ugrodrigo/Controlador_MIDI_Arduino/ControladorMontado.jpg

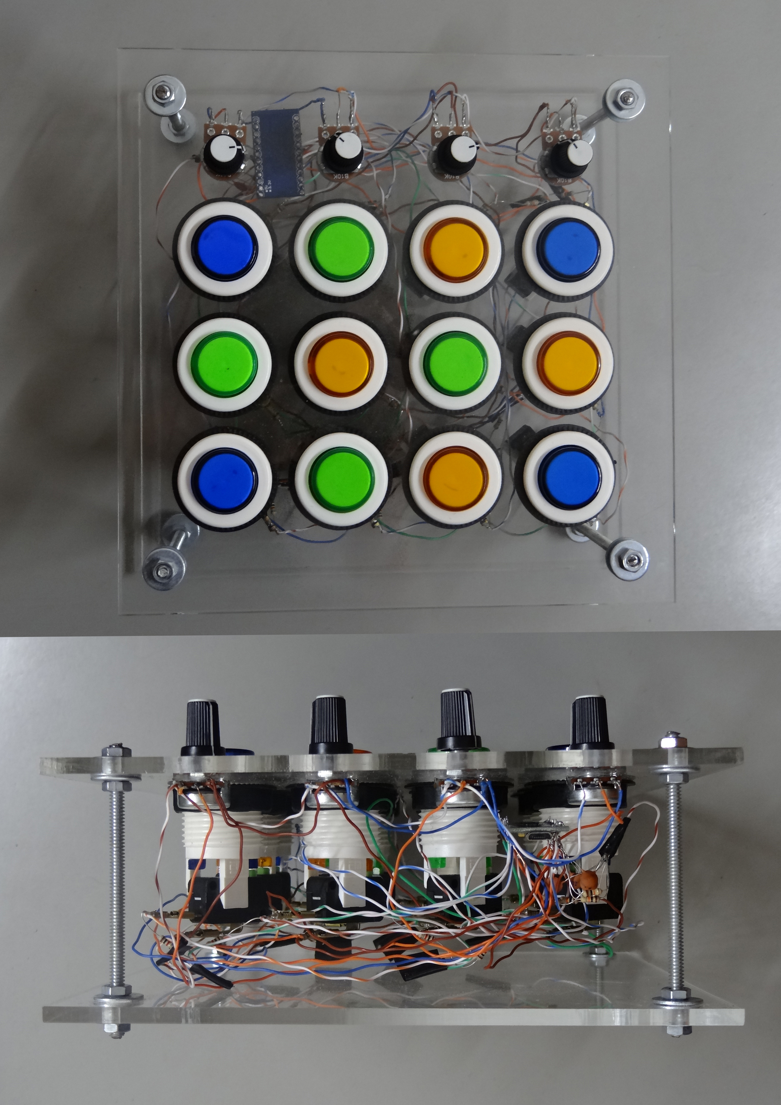
ControladorMontado.jpg
