ugrodrigo/Controlador_MIDI_Arduino/README.md

# Controlador_MIDI_Arduino

Este é um repositório aberto para todos amantes de música que desejam construir seu próprio controlador MIDI.
Aqui serão encontrados: esquemático elétrico, desenho técnico, fluxogramas para programação e o código pronto.
