ugrodrigo/Controlador_MIDI_Arduino/Fluxograma1.jpg

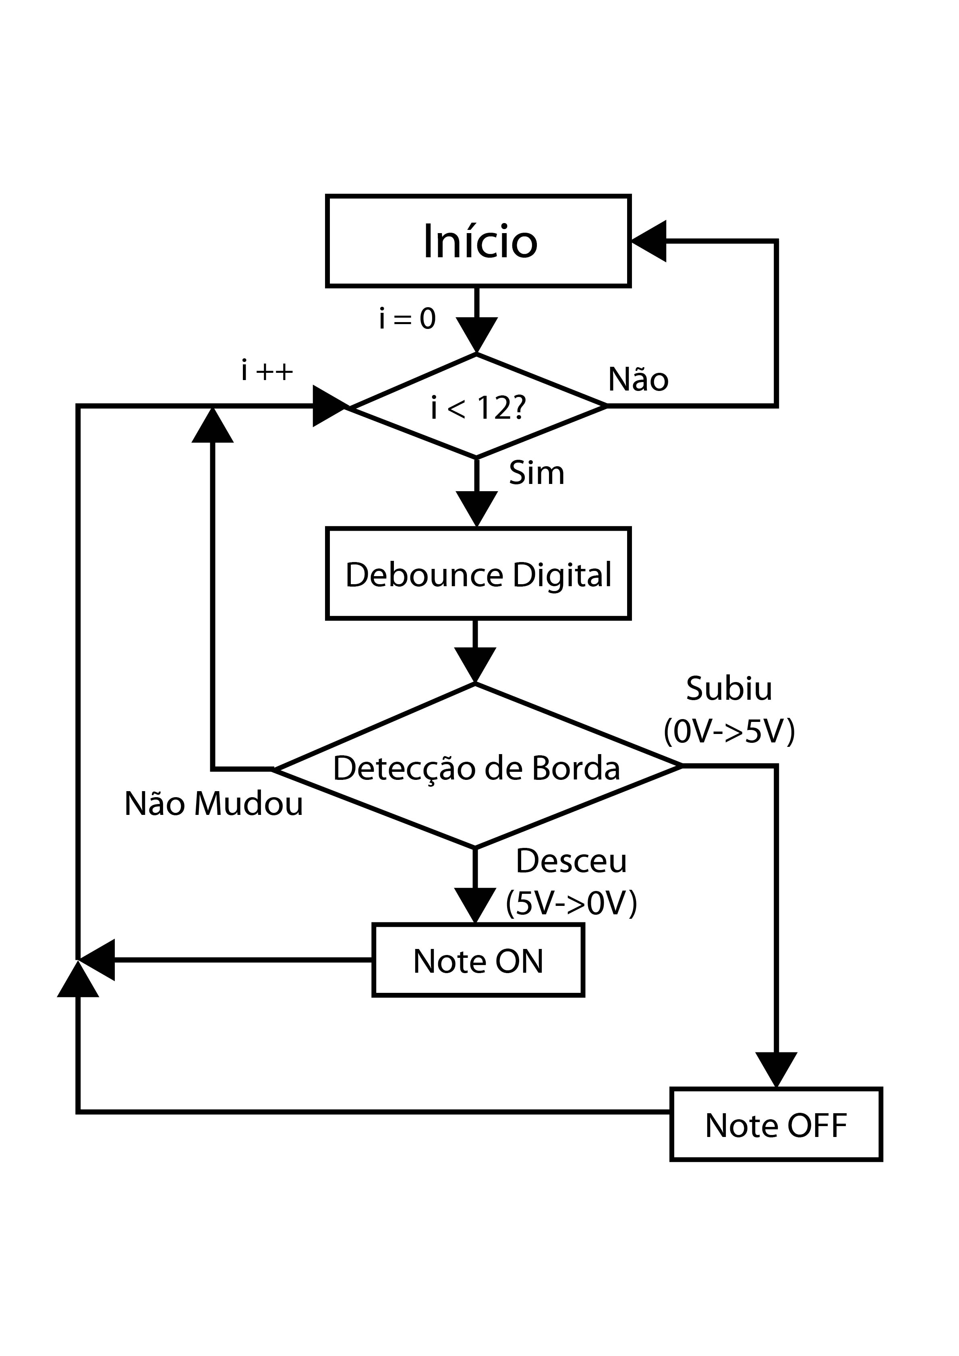
Fluxograma1.jpg
